mengstr/KCSviewer/Images/Clockgen-Breadboard.jpg

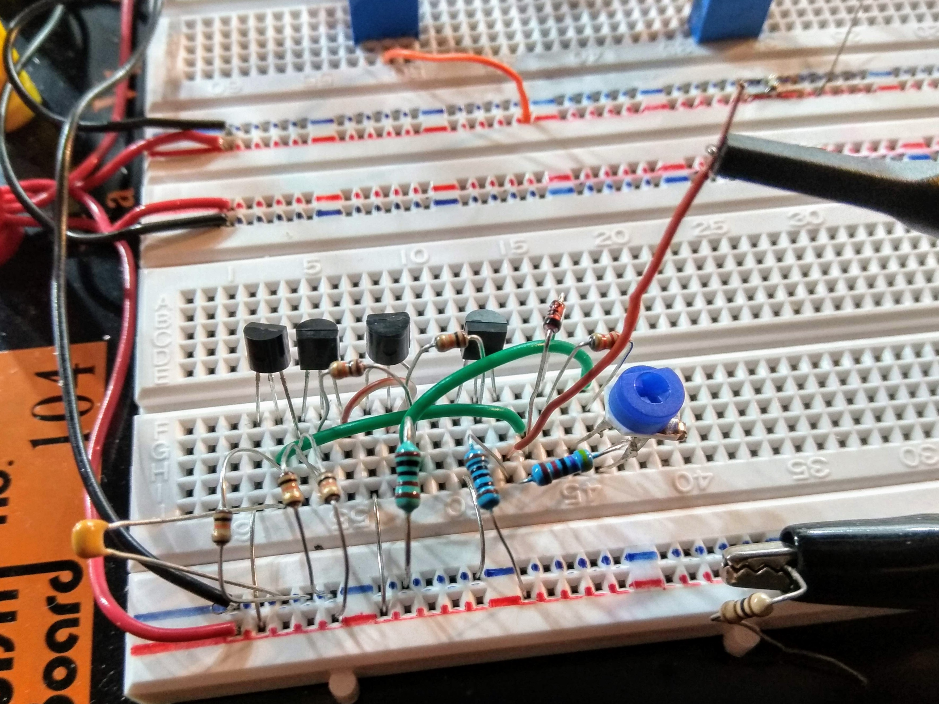
Images/Clockgen-Breadboard.jpg
