mengstr/KCSviewer/(commit log)

2018-09-01 PWM by Arduino
2018-09-01 use lower case extensions
2018-09-01 add comment about the filter
2018-09-30 Case fix for filename
